Vansily/MICHA/Structure registres modbus.docx

# Structure des registre modbus

Adresse relative | Coils / Output coils | Input bits / Discrete inputs | Input registers | Holding registers
0x00 | | | État général** | ID
| Thermistances – alimentation* | | Thermistance 1
| | | Thermistance 2
| | | Thermistance 3
| | | Thermistance 4
0x10 | Pompe – direction | | Pompe – signaux erreur converti | Pompe – vitesse
| Pompe – alimentation | | Pompe – signal servo converti | Pompe – incrémentation
| | | | Pompe – taux d’erreur patinage
0x20 | Cuve 1 – chauffe | | Erreurs***
| Cuve 2 – chauffe
0x30 | Sol. eau chaude
| Sol. eau froide
| Vanne évacuation 1 – alimentation
| Vanne évacuation 1 – direction
| Vanne évacuation 2 – alimentation
| Vanne évacuation 2 – direction

* Ce registre est à cette position afin de laisser la possibilité d’ajouter une alimentation distincte pour chaque thermistance tout en gardant un plan d’adressage le plus cohérent possible (correspondance entre les adresses relatives des alimentations et des thermistances auxquelles elles se rapportent).

** Le registre d’état général est à cet emplacement afin de pouvoir être lu régulièrement en même temps que la valeur des thermistances par l’intermédiaire d’une seule commande modbus (nécessite que les registres soient directement adjacents).

*** Reprend de manière plus précise les erreurs éventuelles

## 1) Coils / output coils

Coils / Output coils
Adresse absolue/relative | Nom valeur | Valeur par défaut | Rôle
00002/0x01 | Thermistances – alimentation | 0 | Permet de gérer l’alimentation des thermistances : - 0 (MICHA) : état BAS - 0 (pasto) : alimentation OFF - 1 (MICHA) : état HAUT - 1 (pasto) : alimentation ON
00016/0x10 | Pompe – direction | 0 | Permet de gérer le sens de rotation de la pompe : - 0 (MICHA) : état BAS - 0 (pasto) : aspiration - 1 (MICHA) : état HAUT - 1 (pasto) : refoulement
00017/0x11 | Pompe – alimentation | 0 | Permet de gérer l’alimentation de la pompe : - 0 (MICHA) : état BAS - 0 (pasto) : alimentation OFF - 1 (MICHA) : état HAUT - 1 (pasto) : alimentation ON
00032/0x20 | Cuve 1 – chauffe | 0 | Permet de gérer la chauffe de la cuve de préchauffe : - 0 (MICHA) : état BAS - 0 (pasto) : chauffe OFF - 1 (MICHA) : état HAUT - 1 (pasto) : chauffe ON
00033/0x21 | Cuve 2 – chauffe | 0 | Permet de gérer la chauffe de la cuve de pasteurisation : - 0 (MICHA) : état BAS - 0 (pasto) : chauffe OFF - 1 (MICHA) : état HAUT - 1 (pasto) : chauffe ON
00048/0x30 | Solénoïde eau chaude | 0 | Permet de gérer l’ouverture de la vanne d’eau chaude lors d’une procédure de nettoyage : - 0 (MICHA) : état BAS - 0 (pasto) : vanne fermée - 1 (MICHA) : état HAUT - 1 (pasto) : vanne ouverte
00049/0x31 | Solénoïde eau froide | 0 | Permet de gérer l’ouverture de la vanne d’eau froide lors d’une procédure de refroidissement : - 0 (MICHA) : état BAS - 0 (pasto) : vanne fermée - 1 (MICHA) : état HAUT - 1 (pasto) : vanne ouverte
00050/0x32 | Vanne évacuation 1 – alimentation | 0 | Permet de gérer l’alimentation de la vanne d’évacuation 1 : - 0 (MICHA) : état BAS - 0 (pasto) : OFF - 1 (MICHA) : état HAUT - 1 (pasto) : ON
00052/0x33 | Vanne évacuation 1 – direction | 0 | Permet de gérer la direction de fonctionnement de la vanne 1 : - 0 (MICHA) : état BAS - 0 (pasto) : dans un sens - 1 (MICHA) : état HAUT - 1 (pasto) : dans l’autre sens
00051/0x34 | Vanne évacuation 2 – alimentation | 0 | Permet de gérer l’alimentation de la vanne d’évacuation 2 : - 0 (MICHA) : état BAS - 0 (pasto) : OFF - 1 (MICHA) : état HAUT - 1 (pasto) : ON
00053/0x35 | Vanne évacuation 2 – direction | 0 | Permet de gérer la direction de fonctionnement de la vanne 2 : - 0 (MICHA) : état BAS - 0 (pasto) : dans un sens - 1 (MICHA) : état HAUT - 1 (pasto) : dans l’autre sens

## 2) Input registers

Input registers
Adresse absolue/relative | Nom valeur | Valeur par défaut | Rôle
30001/0x00 | État général | 0 | Stocke l’état général du pasteurisateur sur 16 bits, chaque bit renseignant : - Bit 0 : patinage de la pompe - Bit 1 : problème thermistance 1 - Bit 2 : problème thermistance 2 - Bit 3 : problème thermistance 3 - Bit 4 : problème thermistance 4 - Bit 5 : erreur pompe - … - Bit 15 : autre problème
30002/0x01 | Thermistance 1 | / | Stocke la température renvoyée par la thermistance située à l’entrée de la cuve de pasteurisation (cuve 2). La valeur stockée est sous format brute et oscille entre 0 et 4095 : - 0 : température maximale - 4095 : température minimale
30003/0x02 | Thermistance 2 | / | Stocke la température renvoyée par la thermistance située à juste avant le tuyau de temporisation. La valeur stockée est sous format brute et oscille entre 0 et 4095 : - 0 : température maximale - 4095 : température minimale
30004/0x03 | Thermistance 3 | / | Stocke la température renvoyée par la thermistance située à la sortie de la cuve de pasteurisation (cuve 2). La valeur stockée est sous format brute et oscille entre 0 et 4095 : - 0 : température maximale - 4095 : température minimale
30005/0x04 | Thermistance 4 | / | Stocke la température renvoyée par la thermistance située ?????????????. La valeur stockée est sous format brute et oscille entre 0 et 4095 : - 0 : température maximale - 4095 : température minimale
30016/0x10 | Pompe – signaux d’erreur | / | Stocke les éventuelles erreurs renvoyées par la pompe.
30017/0x11 | Pompe – signal servo | / | Stocke le nombre de tour renvoyée par la pompe.
30032/0x20 | Erreur | 0 | Renseigne plus précisément sur les erreurs détectées. Chaque bit correspond à une erreur spécifique. Ce registre est consulté si on veut plus d’information sur l’état général.

## 3) Holding registers

Holding registers
Adresse absolue/relative | Nom valeur | Valeur par défaut | Rôle
40001/0x00 | ID | 1 | ID de l’Arduino sur le réseau modbus.
40016/0x10 | Pompe – vitesse | 0 | Permet de gérer la vitesse de la pompe : - 0 : vitesse minimale (arrêt) - 64000 ? : vitesse maximale
40017/0x11 | Pompe – incrémentation | 2000 | Contient la valeur d’incrémentation de fréquence (en Hz) qui permet de gérer l’accélération/décélération de la pompe
40018/0x12 | Pompe – taux d’erreur patinage | ? | Contient le taux d’erreur au-delà duquel le « patinage » de la pompe est considéré comme problématique.
