Vansily/MICHA/Arduino_pinsUsage.jpg

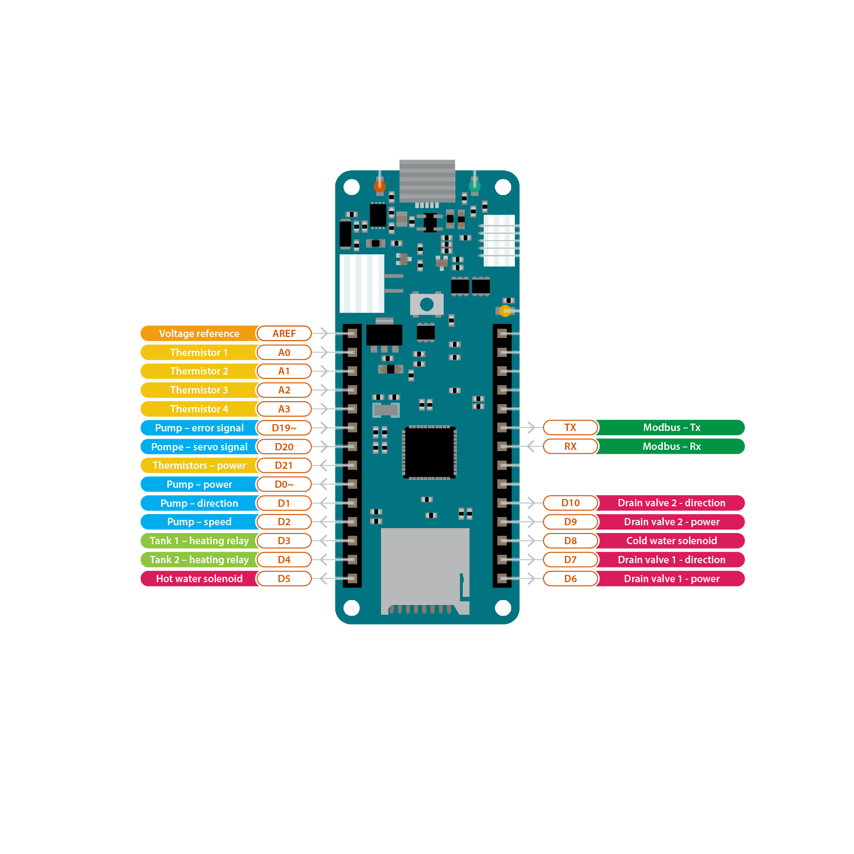
Arduino_pinsUsage.jpg
