Vansily/MICHA/(commit log)

2021-04-06 Renommage
    Renommage du dossier MICHA_v0.3.3 ainsi que de son fichier en MICHA
2021-04-06 Màj code Arduino MICHA
    Mise à jour du code MICHA (v1.0.0)
2021-04-06 Màj registres
    Ajout d'un registre pour stocker l'incrémentation par défaut de la vitesse
2021-04-06 Pump speed pin modification
2021-11-05 MICHAv2.0
    Version 2.0 de MICHA
    [MICHA.brd, MICHA.sch]
